margaretbsavvas/CART360/Progress_photos/measurements.jpg

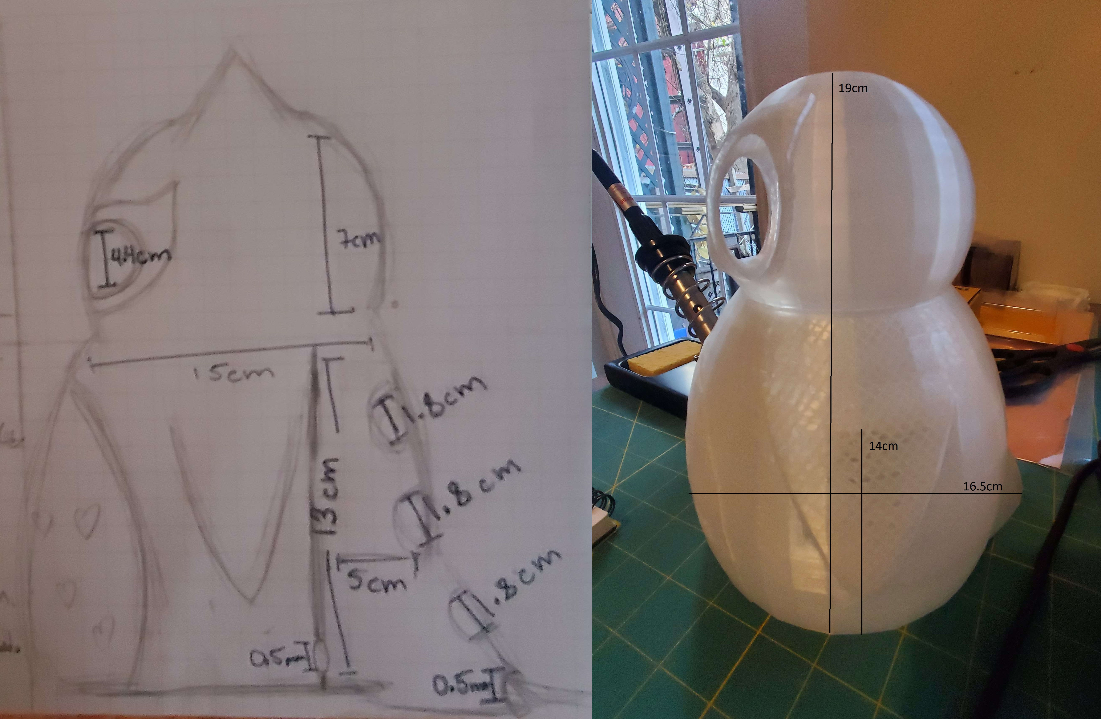
Progress_photos/measurements.jpg
