margaretbsavvas/CART360/Progress_photos/printing_prototype2.jpg

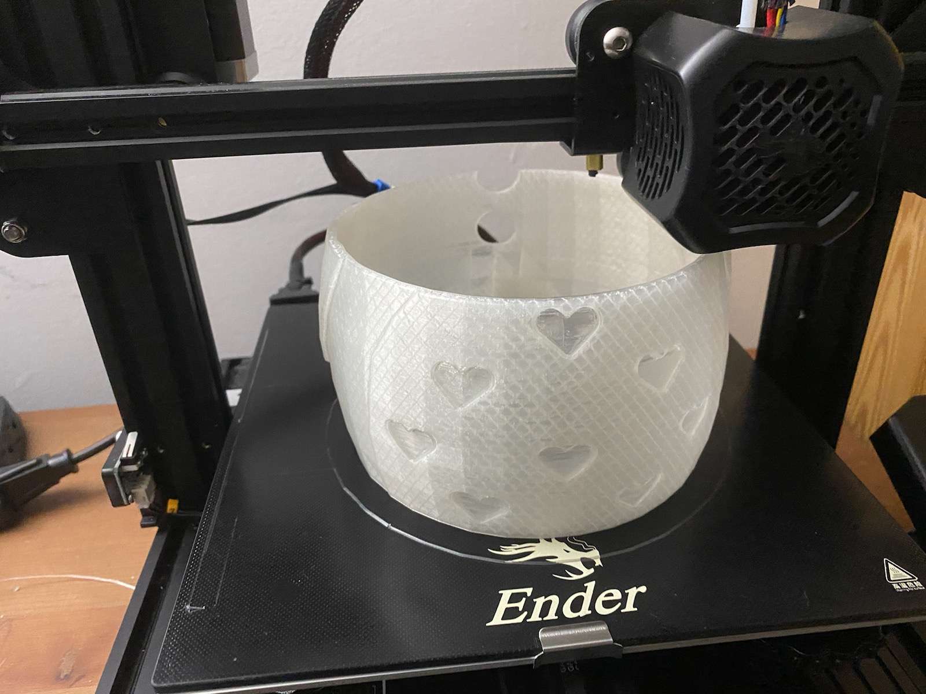
Progress_photos/printing_prototype2.jpg
