margaretbsavvas/CART360/Progress_photos/final_product.jpg

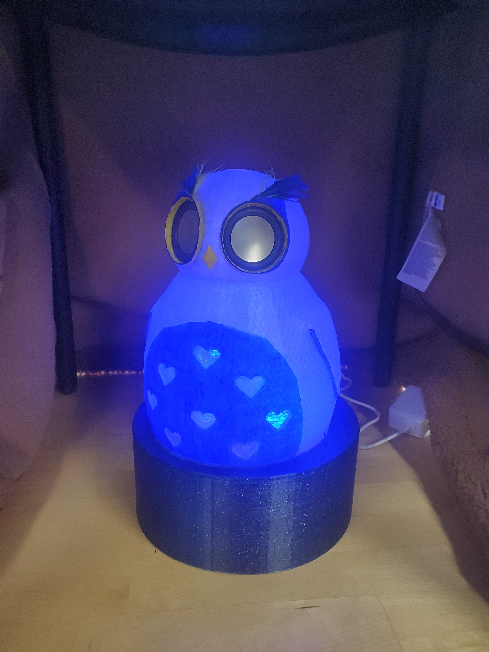
Progress_photos/final_product.jpg
