margaretbsavvas/CART360/Progress_photos/progress_with_pixel_jewel.jpg

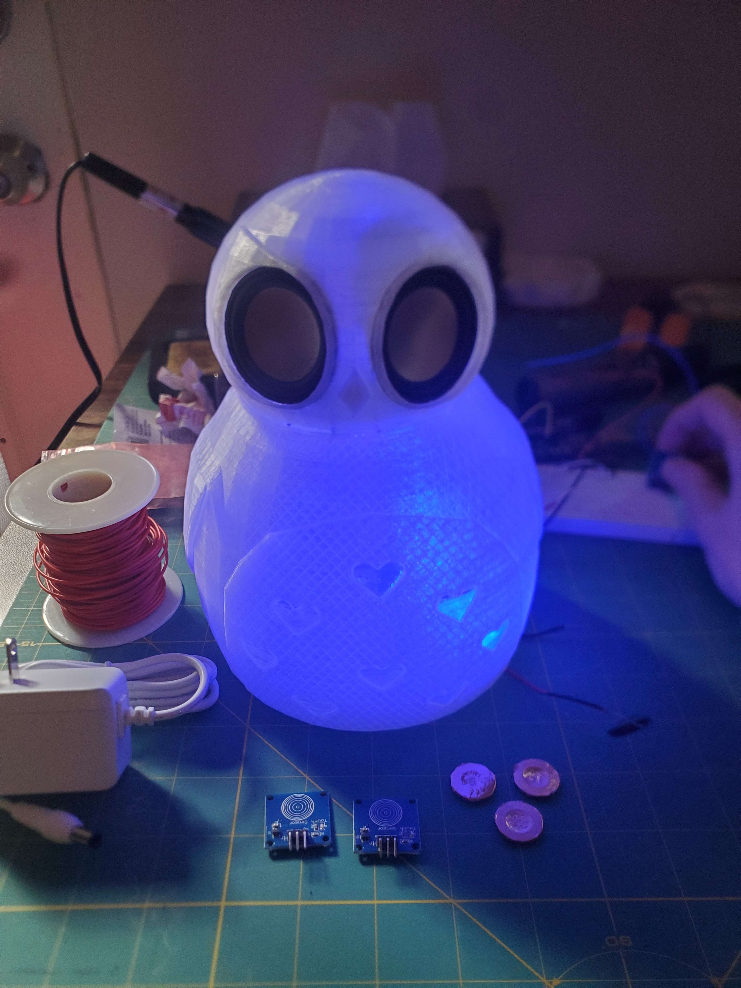
Progress_photos/progress_with_pixel_jewel.jpg
