margaretbsavvas/CART360/Progress_photos/printing_prototype1-fail .jpg

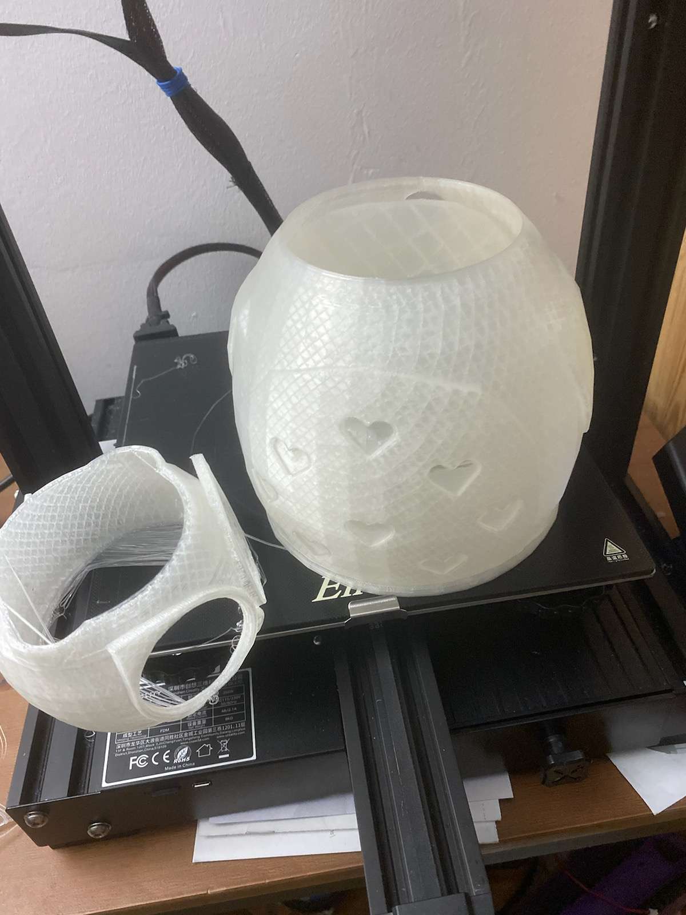
Progress_photos/printing_prototype1-fail .jpg
